esquiree/ATtiny85_WS2812B_Clock/WS2812B Mini Clock Single Brd/WS2812B Mini Clock.pdf

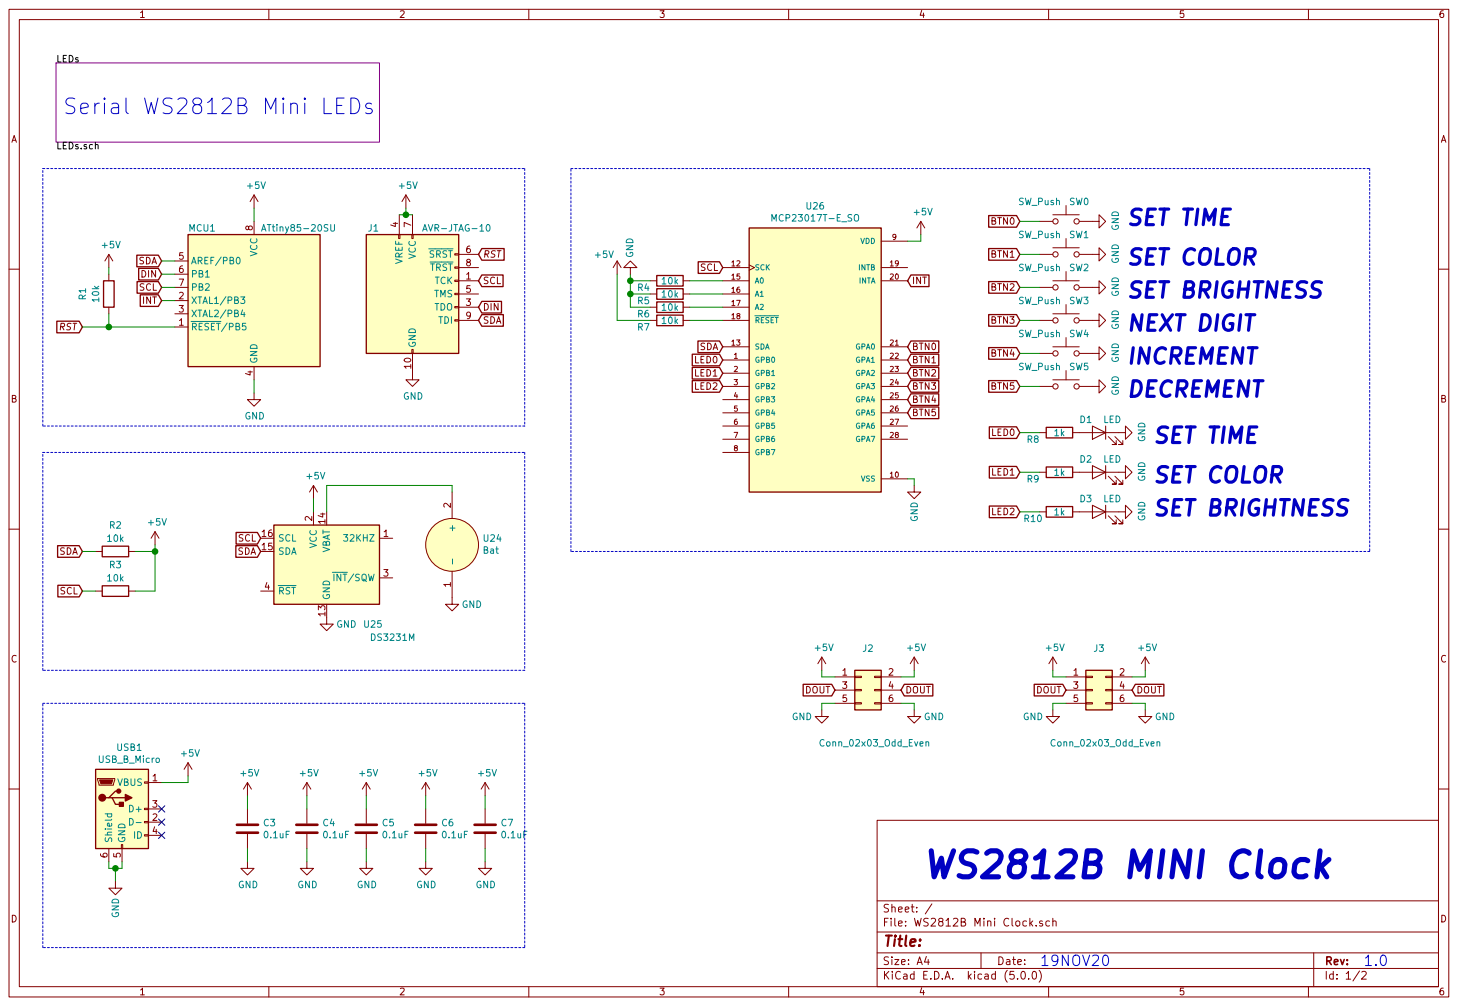
[picture p1: page 1]

LEDs LEDs.sch Serial WS2812B Mini LEDs

RST SCL SDA DIN

SET COLOR
SET BRIGHTNESS
NEXT DIGIT GND DECREMENT
INCREMENT

2 U24 Bat GND GND GND

Id: 1/2 Title: File: WS2812B Mini Clock.sch Sheet: /

19NOV20 | 1.0

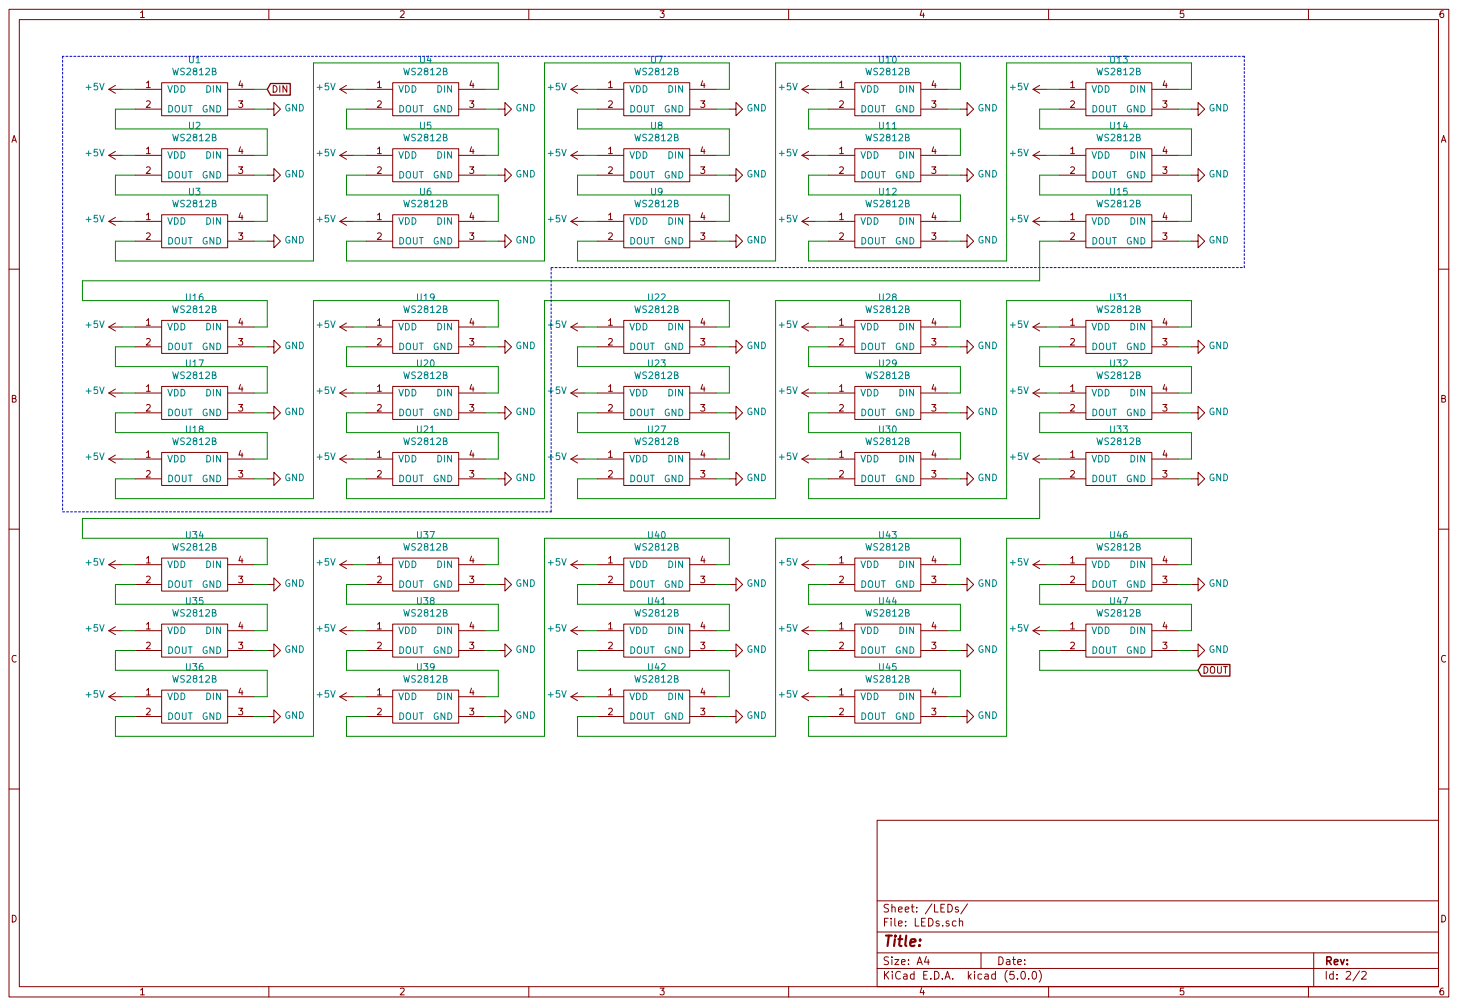
[picture p2: page 2]

Id: 2/2 Title: File: LEDs.sch Sheet: /LEDs/
