esquiree/ATtiny85_WS2812B_Clock/WS2812 Clock/WS2812 Clock.pdf

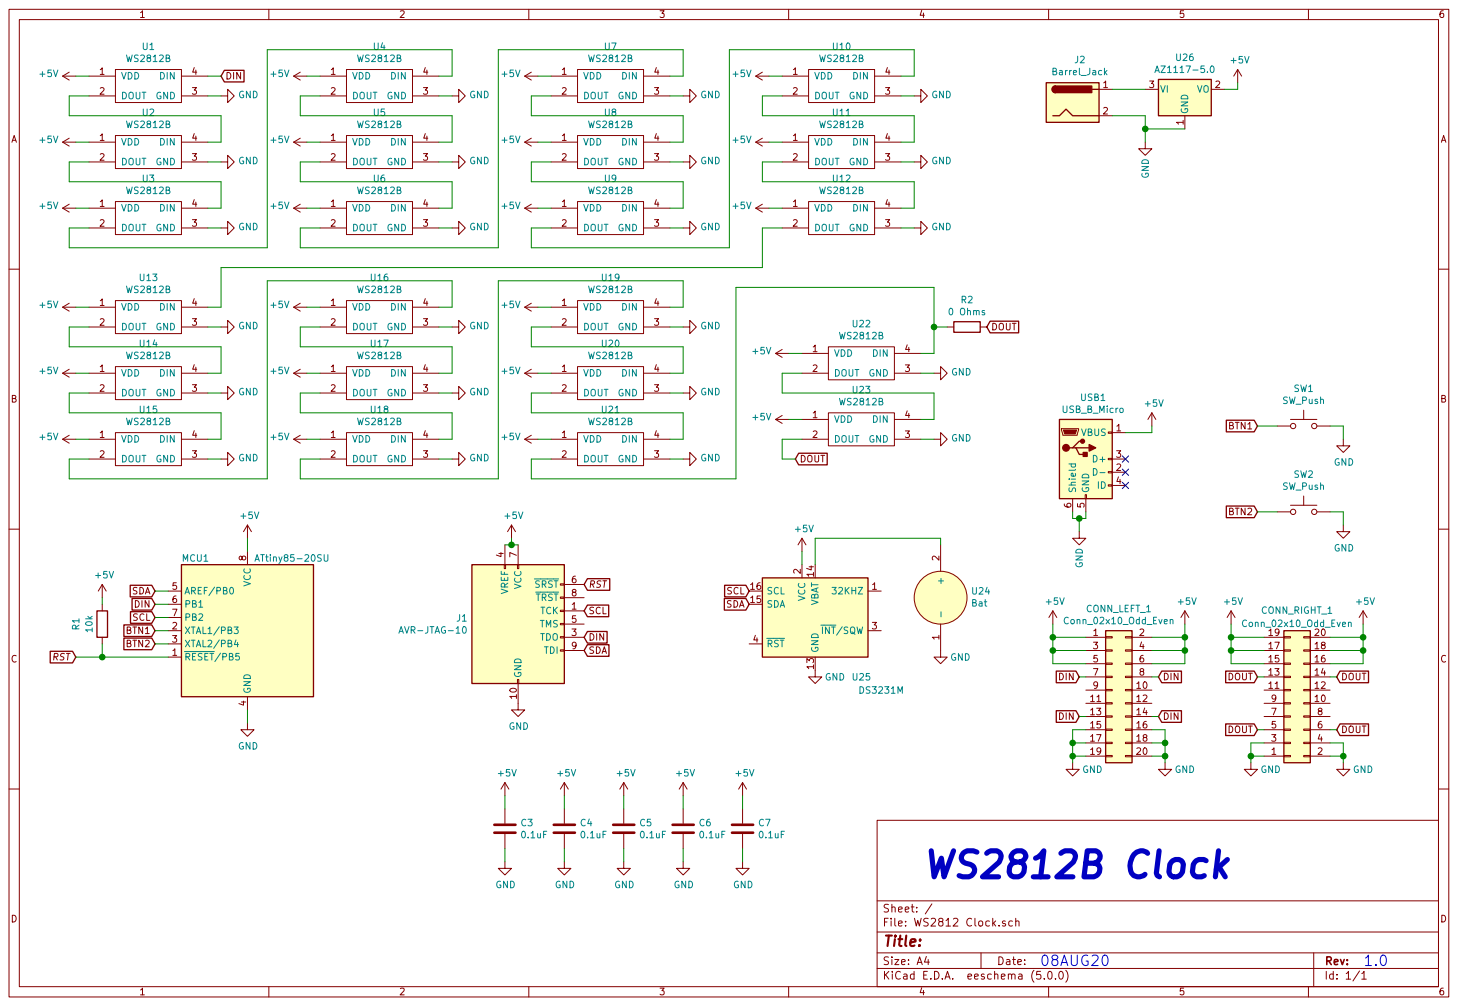
[picture p3: page 1]

RST SCL SDA DIN

Id: 1/1 Title: File: WS2812 Clock.sch Sheet: /
