esquiree/ATtiny85_WS2812B_Clock/WS2812 ClockDIY/pdf.pdf

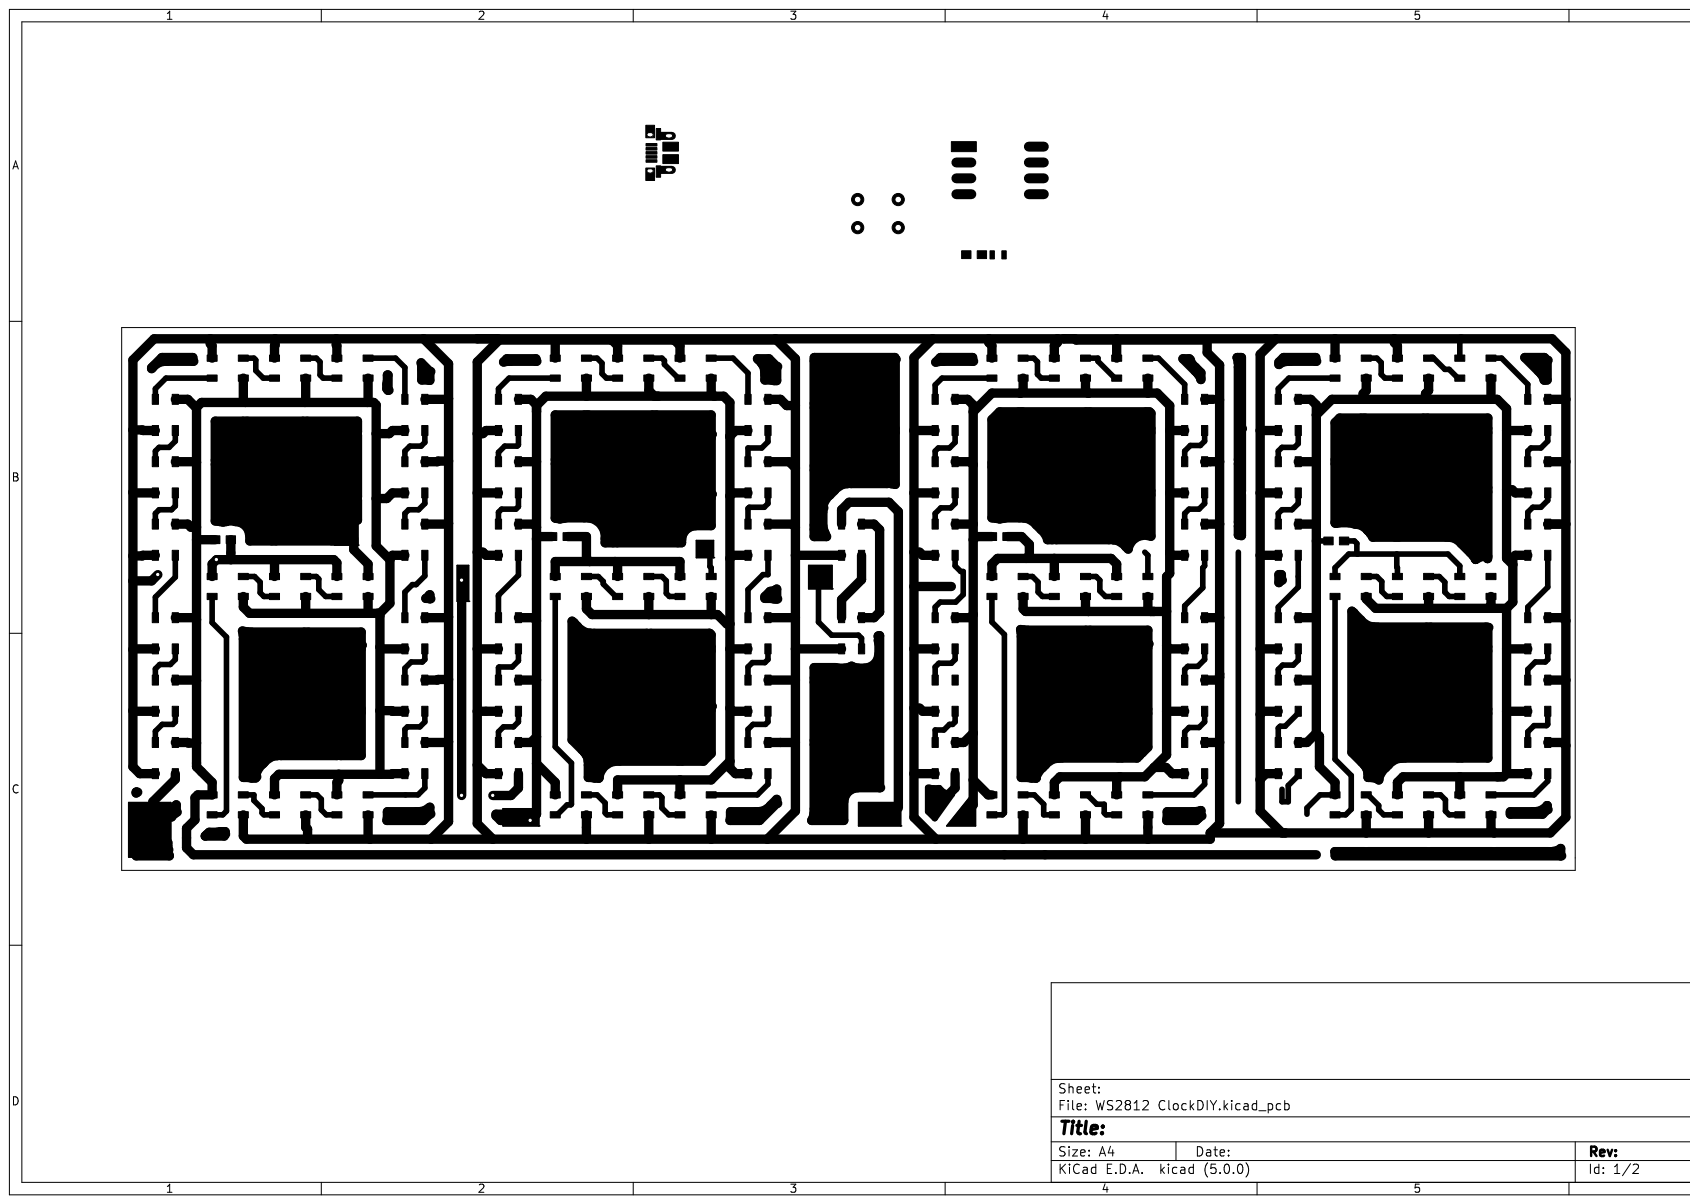
[picture p4: page 1]
