esquiree/ATtiny85_WS2812B_Clock/(list of files, drawings)

Other design files:
WS2812B Mini Clock Single Brd/WS2812B Mini Clock.dsn
