esquiree/ATtiny85_WS2812B_Clock/WS2812B Mini Clock Single Brd/WS2812B Mini Clock.kicad_pcb

## KiCad design WS2812B Mini Clock Single Brd/WS2812B Mini Clock.kicad_pcb (2020-12-10)

Schematic: WS2812B Mini Clock.sch

Parts:
C3, C4, C5, C6, C7: 0.1uF; C_0805_HandSoldering
D1, D2, D3: LED; LED_0805
J1: AVR-JTAG-10; Pin_Header_Straight_2x05_Pitch1.27mm
J2, J3: Conn_01x01; 1mm Mount
J4: Barrel_Jack; BARREL_JACK
MCU1: ATtiny85-20SU; ATtiny85_SMD
R1, R2, R3, R4, R5, R6, R7: 10k; R_0603
R8, R9, R10: 1k; R_0603
SW0, SW1, SW2, SW3, SW4, SW5: SW_Push; SW_SPST_B3S-1000
U24: Bat; CR2032 Housing
U25: DS3231M; SOIC-16W_7.5x10.3mm_Pitch1.27mm
U26: MCP23017T-E_SO; SOIC127P1030X265-28N
U90: AZ1117-5.0; SOT-223-3_TabPin2
USB1: USB_B_Micro; USB_Micro_B_Female_10103594-0001LF; MPN 0473460001

Connections:
+5V: C3.1, C4.1, C5.1, C6.1, C7.1, J1.4, J1.7, J2.1, MCU1.8 (VCC), R1.1, R2.1, R3.1, R7.2, U25.2, U26.9, U90.2 (VO), USB1.1; also elsewhere on the board
BTN0: SW0.1, U26.21
BTN1: SW1.1, U26.22
BTN2: SW2.1, U26.23
BTN3: SW3.1, U26.24
BTN4: SW4.1, U26.25
BTN5: SW5.1, U26.26
DIN: J1.3, MCU1.6 (PB1); also elsewhere on the board
GND: C3.2, C4.2, C5.2, C6.2, C7.2, D1.1, D2.1, D3.1, J1.2, J1.10, J3.1, J4.2, MCU1.4 (GND), R4.2, R5.2, R6.2, SW0.2, SW1.2, SW2.2, SW3.2, SW4.2, SW5.2, U24.1, U25.5, U25.6, U25.7, U25.8, U25.9, U25.10, U25.11, U25.12, U25.13, U26.10, U90.1 (GND), USB1.5; also elsewhere on the board
INT: MCU1.2 (XTAL1/PB3), U26.20
LED0: R8.2, U26.1
LED1: R9.2, U26.2
LED2: R10.2, U26.3
unnamed: D1.2, R8.1
unnamed: D2.2, R9.1
unnamed: D3.2, R10.1
unnamed: J4.1, U90.3 (VI)
unnamed: R4.1, U26.15
unnamed: R5.1, U26.16
unnamed: R6.1, U26.17
unnamed: R7.1, U26.18
unnamed: U24.2, U25.14
RST: J1.6, MCU1.1 (~RESET~/PB5), R1.2
SCL: J1.1, MCU1.7 (PB2), R3.2, U25.16, U26.12
SDA: J1.9, MCU1.5 (AREF/PB0), R2.2, U25.15, U26.13

Notes on the sheet:
WS2812B MINI Clock
Serial WS2812B Mini LEDs
SET TIME
SET COLOR
SET BRIGHTNESS
INCREMENT
NEXT DIGIT
DECREMENT

Schematic: LEDs.sch

Parts:
U1, U2, U3, U4, U5, U6, U7, U8, U9, U10, U11, U12, U13, U14, U15, U16, U17, U18, U19, U20, U21, U22, U23, U27, U28, U29, U30, U31, U32, U33, U34, U35, U36, U37, U38, U39, U40, U41, U42, U43, U44, U45, U46, U47, U48, U49, U50, U51, U52, U53, U54, U55, U56, U57, U58, U59, U60, U61, U62, U63, U64, U65, U66, U67, U68, U69, U70, U71, U72, U73, U74, U75, U76, U77, U78, U79, U80, U81, U82, U83, U84, U85, U86, U87, U88, U89: WS2812B; WS2812B-MINI

Connections:
+5V: U1.1, U2.1, U3.1, U4.1, U5.1, U6.1, U7.1, U8.1, U9.1, U10.1, U11.1, U12.1, U13.1, U14.1, U15.1, U16.1, U17.1, U18.1, U19.1, U20.1, U21.1, U22.1, U23.1, U27.1, U28.1, U29.1, U30.1, U31.1, U32.1, U33.1, U34.1, U35.1, U36.1, U37.1, U38.1, U39.1, U40.1, U41.1, U42.1, U43.1, U44.1, U45.1, U46.1, U47.1, U48.1, U49.1, U50.1, U51.1, U52.1, U53.1, U54.1, U55.1, U56.1, U57.1, U58.1, U59.1, U60.1, U61.1, U62.1, U63.1, U64.1, U65.1, U66.1, U67.1, U68.1, U69.1, U70.1, U71.1, U72.1, U73.1, U74.1, U75.1, U76.1, U77.1, U78.1, U79.1, U80.1, U81.1, U82.1, U83.1, U84.1, U85.1, U86.1, U87.1, U88.1, U89.1; also elsewhere on the board
DIN: U1.4; also elsewhere on the board
DOUT: U47.2, U48.4
GND: U1.3, U2.3, U3.3, U4.3, U5.3, U6.3, U7.3, U8.3, U9.3, U10.3, U11.3, U12.3, U13.3, U14.3, U15.3, U16.3, U17.3, U18.3, U19.3, U20.3, U21.3, U22.3, U23.3, U27.3, U28.3, U29.3, U30.3, U31.3, U32.3, U33.3, U34.3, U35.3, U36.3, U37.3, U38.3, U39.3, U40.3, U41.3, U42.3, U43.3, U44.3, U45.3, U46.3, U47.3, U48.3, U49.3, U50.3, U51.3, U52.3, U53.3, U54.3, U55.3, U56.3, U57.3, U58.3, U59.3, U60.3, U61.3, U62.3, U63.3, U64.3, U65.3, U66.3, U67.3, U68.3, U69.3, U70.3, U71.3, U72.3, U73.3, U74.3, U75.3, U76.3, U77.3, U78.3, U79.3, U80.3, U81.3, U82.3, U83.3, U84.3, U85.3, U86.3, U87.3, U88.3, U89.3; also elsewhere on the board
unnamed: U1.2, U2.4
unnamed: U2.2, U3.4
unnamed: U3.2, U4.4
unnamed: U4.2, U5.4
unnamed: U5.2, U6.4
unnamed: U6.2, U7.4
unnamed: U7.2, U8.4
unnamed: U8.2, U9.4
unnamed: U10.2, U11.4
unnamed: U9.2, U10.4
unnamed: U11.2, U12.4
unnamed: U12.2, U13.4
unnamed: U13.2, U14.4
unnamed: U14.2, U15.4
unnamed: U15.2, U16.4
unnamed: U16.2, U17.4
unnamed: U17.2, U18.4
unnamed: U18.2, U19.4
unnamed: U19.2, U20.4
unnamed: U20.2, U21.4
unnamed: U21.2, U22.4
unnamed: U22.2, U23.4
unnamed: U23.2, U27.4
unnamed: U27.2, U28.4
unnamed: U28.2, U29.4
unnamed: U29.2, U30.4
unnamed: U30.2, U31.4
unnamed: U31.2, U32.4
unnamed: U32.2, U33.4
unnamed: U33.2, U34.4
unnamed: U34.2, U35.4
unnamed: U35.2, U36.4
unnamed: U36.2, U37.4
unnamed: U37.2, U38.4
unnamed: U38.2, U39.4
unnamed: U39.2, U40.4
unnamed: U40.2, U41.4
unnamed: U41.2, U42.4
unnamed: U42.2, U43.4
unnamed: U43.2, U44.4
unnamed: U44.2, U45.4
unnamed: U45.2, U46.4
unnamed: U46.2, U47.4
unnamed: U48.2, U53.4
unnamed: U49.2, U54.4
unnamed: U49.4, U58.2
unnamed: U50.2, U55.4
unnamed: U50.4, U59.2
unnamed: U51.2, U56.4
unnamed: U51.4, U60.2
unnamed: U52.2, U57.4
unnamed: U52.4, U61.2
unnamed: U53.2, U58.4
unnamed: U54.2, U59.4
unnamed: U55.2, U60.4
unnamed: U56.2, U61.4
unnamed: U57.2, U62.4
unnamed: U62.2, U63.4
unnamed: U63.2, U68.4
unnamed: U64.2, U69.4
unnamed: U64.4, U73.2
unnamed: U65.2, U70.4
unnamed: U65.4, U74.2
unnamed: U66.2, U71.4
unnamed: U66.4, U75.2
unnamed: U67.2, U72.4
unnamed: U67.4, U76.2
unnamed: U68.2, U73.4
unnamed: U69.2, U74.4
unnamed: U70.2, U75.4
unnamed: U71.2, U76.4
unnamed: U72.2, U77.4
unnamed: U77.2, U78.4
unnamed: U78.2, U82.4
unnamed: U79.2, U83.4
unnamed: U79.4, U86.2
unnamed: U80.2, U84.4
unnamed: U80.4, U87.2
unnamed: U81.2, U85.4
unnamed: U81.4, U88.2
unnamed: U82.2, U86.4
unnamed: U83.2, U87.4
unnamed: U84.2, U88.4
unnamed: U85.2, U89.4

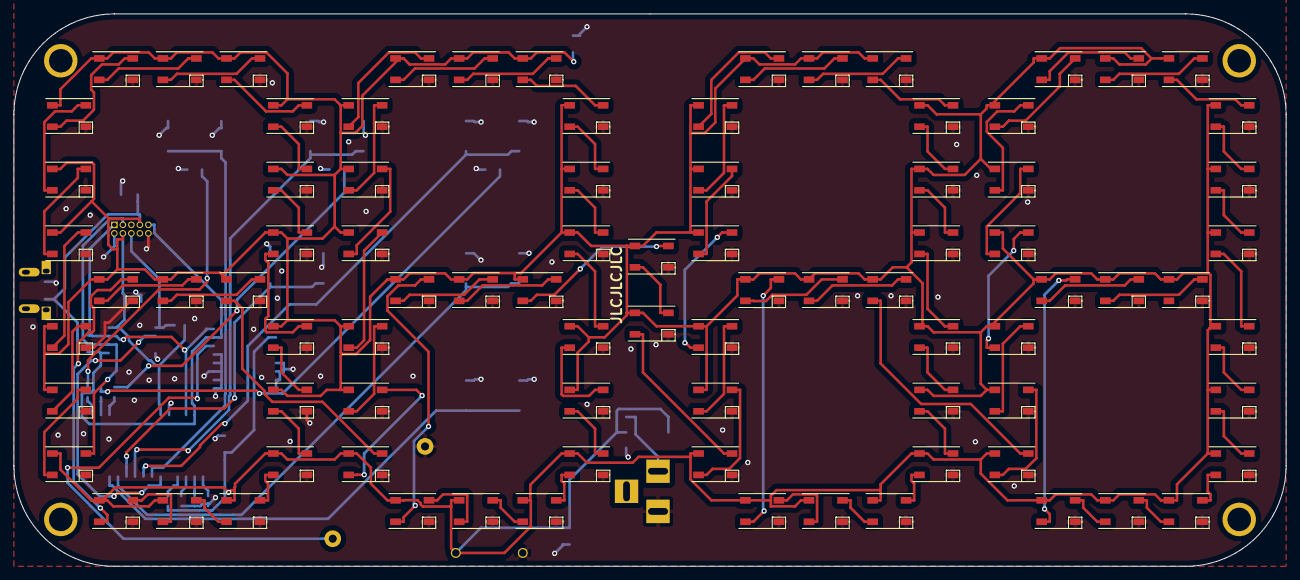
[picture p5: board WS2812B Mini Clock.kicad_pcb from above]

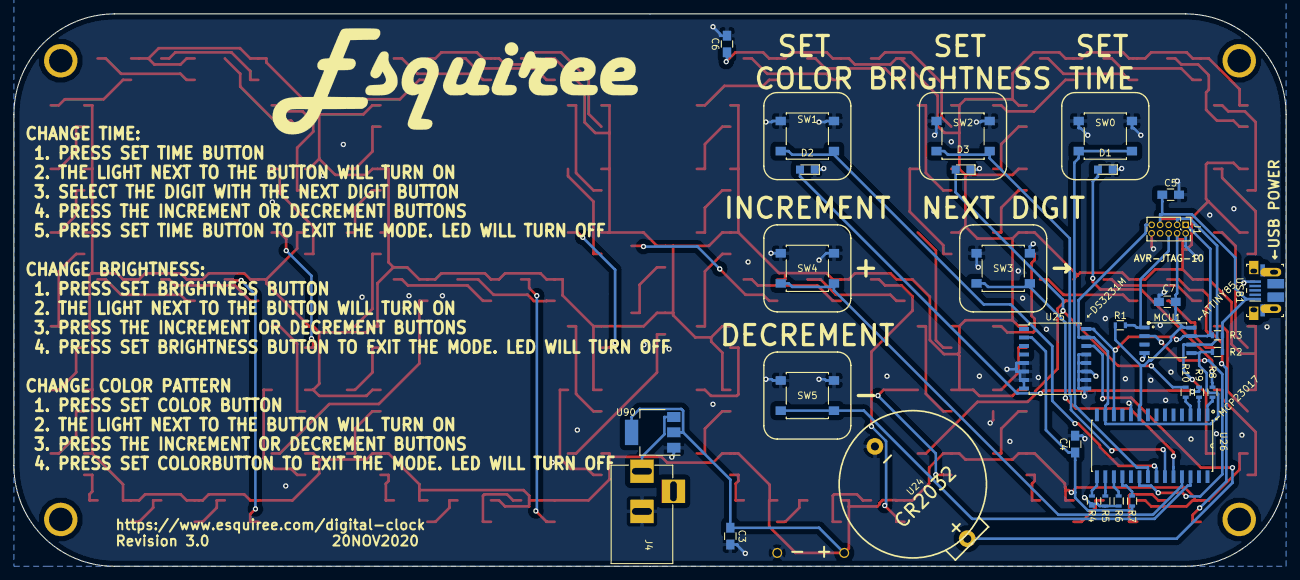
[picture p6: board WS2812B Mini Clock.kicad_pcb from below]

Board: 2 copper layers, 190.0 x 82.5 mm, 123 parts (32 on the bottom side), 110 nets.

Other parts of the board:
REF2, REF3, REF4: 4mm Mount
